khuongvanan/iot-monitoring-broadcast/hardware/esp32-controller/k3.1.csv

Reference | Qty | Value | DNP | Exclude from BOM | Exclude from Board | Exclude from Simulation | Exclude from Position Files | Footprint | Datasheet
C1,C10,C12 | 3 | 10uF/25V(20%) |  |  |  |  | ${EXCLUDE_FROM_POS_FILES} | Capacitor_SMD:C_1206_3216Metric_Pad1.33x1.80mm_HandSolder
C2,C4,C7,C8 | 4 | 0.1uF/50V(10%) |  |  |  |  | ${EXCLUDE_FROM_POS_FILES} | Capacitor_SMD:C_0805_2012Metric_Pad1.18x1.45mm_HandSolder
C3 | 1 | 10uF/5V(20%) |  |  |  |  | ${EXCLUDE_FROM_POS_FILES} | Capacitor_SMD:C_0805_2012Metric_Pad1.18x1.45mm_HandSolder
C5 | 1 | 10uF |  |  |  |  | ${EXCLUDE_FROM_POS_FILES} | Capacitor_SMD:C_0805_2012Metric_Pad1.18x1.45mm_HandSolder
C6,C11 | 2 | 0.1uF |  |  |  |  | ${EXCLUDE_FROM_POS_FILES} | Capacitor_SMD:C_0805_2012Metric_Pad1.18x1.45mm_HandSolder
C9 | 1 | 1000uF/16V |  |  |  |  | ${EXCLUDE_FROM_POS_FILES} | Capacitor_THT:CP_Radial_D8.0mm_P3.50mm
C13 | 1 | 105 |  |  |  |  | ${EXCLUDE_FROM_POS_FILES} | Capacitor_SMD:C_0805_2012Metric_Pad1.18x1.45mm_HandSolder
C14 | 1 | 1uF/16V(10%) |  |  |  |  | ${EXCLUDE_FROM_POS_FILES} | Capacitor_SMD:C_0805_2012Metric_Pad1.18x1.45mm_HandSolder
C15,C16 | 2 | 330uF/35V |  |  |  |  | ${EXCLUDE_FROM_POS_FILES} | Capacitor_THT:CP_Radial_D8.0mm_P5.00mm
D1 | 1 | 1N5822 |  |  |  |  | ${EXCLUDE_FROM_POS_FILES} | Diode_SMD:D_SMC_Handsoldering | http://www.vishay.com/docs/88526/1n5820.pdf
D2 | 1 | LED-RED |  |  |  |  | ${EXCLUDE_FROM_POS_FILES} | LED_SMD:LED_0805_2012Metric_Pad1.15x1.40mm_HandSolder
D3 | 1 | SK6805 |  |  |  |  | ${EXCLUDE_FROM_POS_FILES} | LED_SMD:LED_SK6805_PLCC4_2.4x2.7mm_P1.3mm | https://cdn-shop.adafruit.com/product-files/3484/3484_Datasheet.pdf
D4,D10 | 2 | D_Schottky |  |  |  |  | ${EXCLUDE_FROM_POS_FILES} | Diode_SMD:D_SMA_Handsoldering
D5,D6,D7,D8,D9,D11 | 6 | D_TVS |  |  |  |  | ${EXCLUDE_FROM_POS_FILES} | Diode_SMD:D_1206_3216Metric_Pad1.42x1.75mm_HandSolder
J1 | 1 | SHT31 |  |  |  |  | ${EXCLUDE_FROM_POS_FILES} | Connector_JST:JST_EH_B4B-EH-A_1x04_P2.50mm_Vertical
J2 | 1 | YG1006 |  |  |  |  | ${EXCLUDE_FROM_POS_FILES} | Connector_JST:JST_EH_B3B-EH-A_1x03_P2.50mm_Vertical
J3 | 1 | Conn_01x02 |  |  |  |  | ${EXCLUDE_FROM_POS_FILES} | TerminalBlock_Phoenix:TerminalBlock_Phoenix_MKDS-1,5-2-5.08_1x02_P5.08mm_Horizontal
J4 | 1 | USB_C ESP USB |  |  |  |  | ${EXCLUDE_FROM_POS_FILES} | Connector_USB:USB_C_Receptacle_HCTL_HC-TYPE-C-16P-01A | https://www.usb.org/sites/default/files/documents/usb_type-c.zip
J5 | 1 | USB_C USB TO UART |  |  |  |  | ${EXCLUDE_FROM_POS_FILES} | Connector_USB:USB_C_Receptacle_HCTL_HC-TYPE-C-16P-01A | https://www.usb.org/sites/default/files/documents/usb_type-c.zip
J7 | 1 | GND |  |  |  |  | ${EXCLUDE_FROM_POS_FILES} | Connector_JST:JST_EH_B3B-EH-A_1x03_P2.50mm_Vertical
J9 | 1 | Sound |  |  |  |  | ${EXCLUDE_FROM_POS_FILES} | Connector_JST:JST_EH_B5B-EH-A_1x05_P2.50mm_Vertical
J10 | 1 | 4G |  |  |  |  | ${EXCLUDE_FROM_POS_FILES} | Connector_JST:JST_EH_B5B-EH-A_1x05_P2.50mm_Vertical
L1 | 1 | 68uH/2A |  |  |  |  | ${EXCLUDE_FROM_POS_FILES} | Inductor_SMD:L_Taiyo-Yuden_NR-80xx_HandSoldering
Q1,Q2 | 2 | Q_NPN_BEC |  |  |  |  | ${EXCLUDE_FROM_POS_FILES} | Package_TO_SOT_SMD:SOT-23
R1 | 1 | 1k |  |  |  |  | ${EXCLUDE_FROM_POS_FILES} | Resistor_SMD:R_0805_2012Metric_Pad1.20x1.40mm_HandSolder
R2,R13,R14,R15 | 4 | 0(1%) |  |  |  |  | ${EXCLUDE_FROM_POS_FILES} | Resistor_SMD:R_0805_2012Metric_Pad1.20x1.40mm_HandSolder
R4,R6 | 2 | 22R |  |  |  |  | ${EXCLUDE_FROM_POS_FILES} | Resistor_SMD:R_0805_2012Metric_Pad1.20x1.40mm_HandSolder
R7,R8 | 2 | 100k |  |  |  |  | ${EXCLUDE_FROM_POS_FILES} | Resistor_SMD:R_0805_2012Metric_Pad1.20x1.40mm_HandSolder
R10,R11,R12 | 3 | 10k(1%) |  |  |  |  | ${EXCLUDE_FROM_POS_FILES} | Resistor_SMD:R_0805_2012Metric_Pad1.20x1.40mm_HandSolder
R16 | 1 | 5 .1K |  |  |  |  | ${EXCLUDE_FROM_POS_FILES} | Resistor_SMD:R_0805_2012Metric_Pad1.20x1.40mm_HandSolder
R17,R18,R19 | 3 | 5.1K |  |  |  |  | ${EXCLUDE_FROM_POS_FILES} | Resistor_SMD:R_0805_2012Metric_Pad1.20x1.40mm_HandSolder
SW1,SW2 | 2 | SW_Push |  |  |  |  | ${EXCLUDE_FROM_POS_FILES} | Button_Switch_SMD:SW_SPST_FSMSM
U1 | 1 | ESP32-S3-WROOM-1 |  |  |  |  | ${EXCLUDE_FROM_POS_FILES} | RF_Module:ESP32-S3-WROOM-1 | https://www.espressif.com/sites/default/files/documentation/esp32-s3-wroom-1_wroom-1u_datasheet_en.pdf
U2 | 1 | CH340C |  |  |  |  | ${EXCLUDE_FROM_POS_FILES} | Package_SO:SOIC-16_3.9x9.9mm_P1.27mm | https://datasheet.lcsc.com/szlcsc/Jiangsu-Qin-Heng-CH340C_C84681.pdf
U3 | 1 | AMS1117-3.3 |  |  |  |  | ${EXCLUDE_FROM_POS_FILES} | Package_TO_SOT_SMD:SOT-223-3_TabPin2 | http://www.advanced-monolithic.com/pdf/ds1117.pdf
U5 | 1 | XL1509-5.0 |  |  |  |  | ${EXCLUDE_FROM_POS_FILES} | Package_SO:SOIC-8_3.9x4.9mm_P1.27mm | https://datasheet.lcsc.com/lcsc/1809050422_XLSEMI-XL1509-5-0E1_C61063.pdf
