khuongvanan/iot-monitoring-broadcast/hardware/power-amplifier/k1.csv

Reference | Qty | Value | DNP | Exclude from BOM | Exclude from Board | Exclude from Simulation | Exclude from Position Files | Footprint | Datasheet
C1,C17 | 2 | 220uF\35V |  |  |  |  | ${EXCLUDE_FROM_POS_FILES} | Capacitor_THT:CP_Radial_D22.0mm_P10.00mm_SnapIn
C2,C5 | 2 | 100nF |  |  |  |  | ${EXCLUDE_FROM_POS_FILES} | Capacitor_SMD:C_0201_0603Metric_Pad0.64x0.40mm_HandSolder
C3,C4 | 2 | 1nF |  |  |  |  | ${EXCLUDE_FROM_POS_FILES} | Capacitor_SMD:C_0201_0603Metric_Pad0.64x0.40mm_HandSolder
C6,C16 | 2 | 1nF |  |  |  |  | ${EXCLUDE_FROM_POS_FILES} | Capacitor_SMD:C_0603_1608Metric_Pad1.08x0.95mm_HandSolder
C7 | 1 | 1uF |  |  |  |  | ${EXCLUDE_FROM_POS_FILES} | Resistor_SMD:R_0805_2012Metric_Pad1.20x1.40mm_HandSolder
C8,C14 | 2 | 1uF |  |  |  |  | ${EXCLUDE_FROM_POS_FILES} | Capacitor_SMD:C_1206_3216Metric_Pad1.33x1.80mm_HandSolder
C9,C15 | 2 | 1uF |  |  |  |  | ${EXCLUDE_FROM_POS_FILES} | Capacitor_SMD:C_0805_2012Metric_Pad1.18x1.45mm_HandSolder
C10,C11,C12,C13 | 4 | 220nF\X5R |  |  |  |  | ${EXCLUDE_FROM_POS_FILES} | Capacitor_SMD:C_0201_0603Metric_Pad0.64x0.40mm_HandSolder
J1 | 1 | POWER 15V |  |  |  |  | ${EXCLUDE_FROM_POS_FILES} | Connector:Banana_Jack_2Pin
J2 | 1 | AUDIO IN |  |  |  |  | ${EXCLUDE_FROM_POS_FILES} | Connector:Banana_Jack_2Pin
J3 | 1 | AUDIO OUT |  |  |  |  | ${EXCLUDE_FROM_POS_FILES} | Connector:Banana_Jack_2Pin
L1,L2 | 2 | 10uH |  |  |  |  | ${EXCLUDE_FROM_POS_FILES} | Inductor_SMD:L_Panasonic_PCC-M1050M
R1,R3,R4 | 3 | 100k |  |  |  |  | ${EXCLUDE_FROM_POS_FILES} | Resistor_SMD:R_0603_1608Metric_Pad0.98x0.95mm_HandSolder
R2 | 1 | 20k |  |  |  |  | ${EXCLUDE_FROM_POS_FILES} | Resistor_SMD:R_0603_1608Metric_Pad0.98x0.95mm_HandSolder
R5,R6 | 2 | 3.3R |  |  |  |  | ${EXCLUDE_FROM_POS_FILES} | Resistor_SMD:R_0805_2012Metric_Pad1.20x1.40mm_HandSolder
U3 | 1 | TPA3118D2DAPR |  |  |  |  | ${EXCLUDE_FROM_POS_FILES} | TPA3118D2DAPR:SOP65P810X120-33N
