khuongvanan/iot-monitoring-broadcast/hardware/audio-dac/k2.2.kicad_pcb

## KiCad design hardware/audio-dac/k2.2.kicad_pcb (2026-10-30)

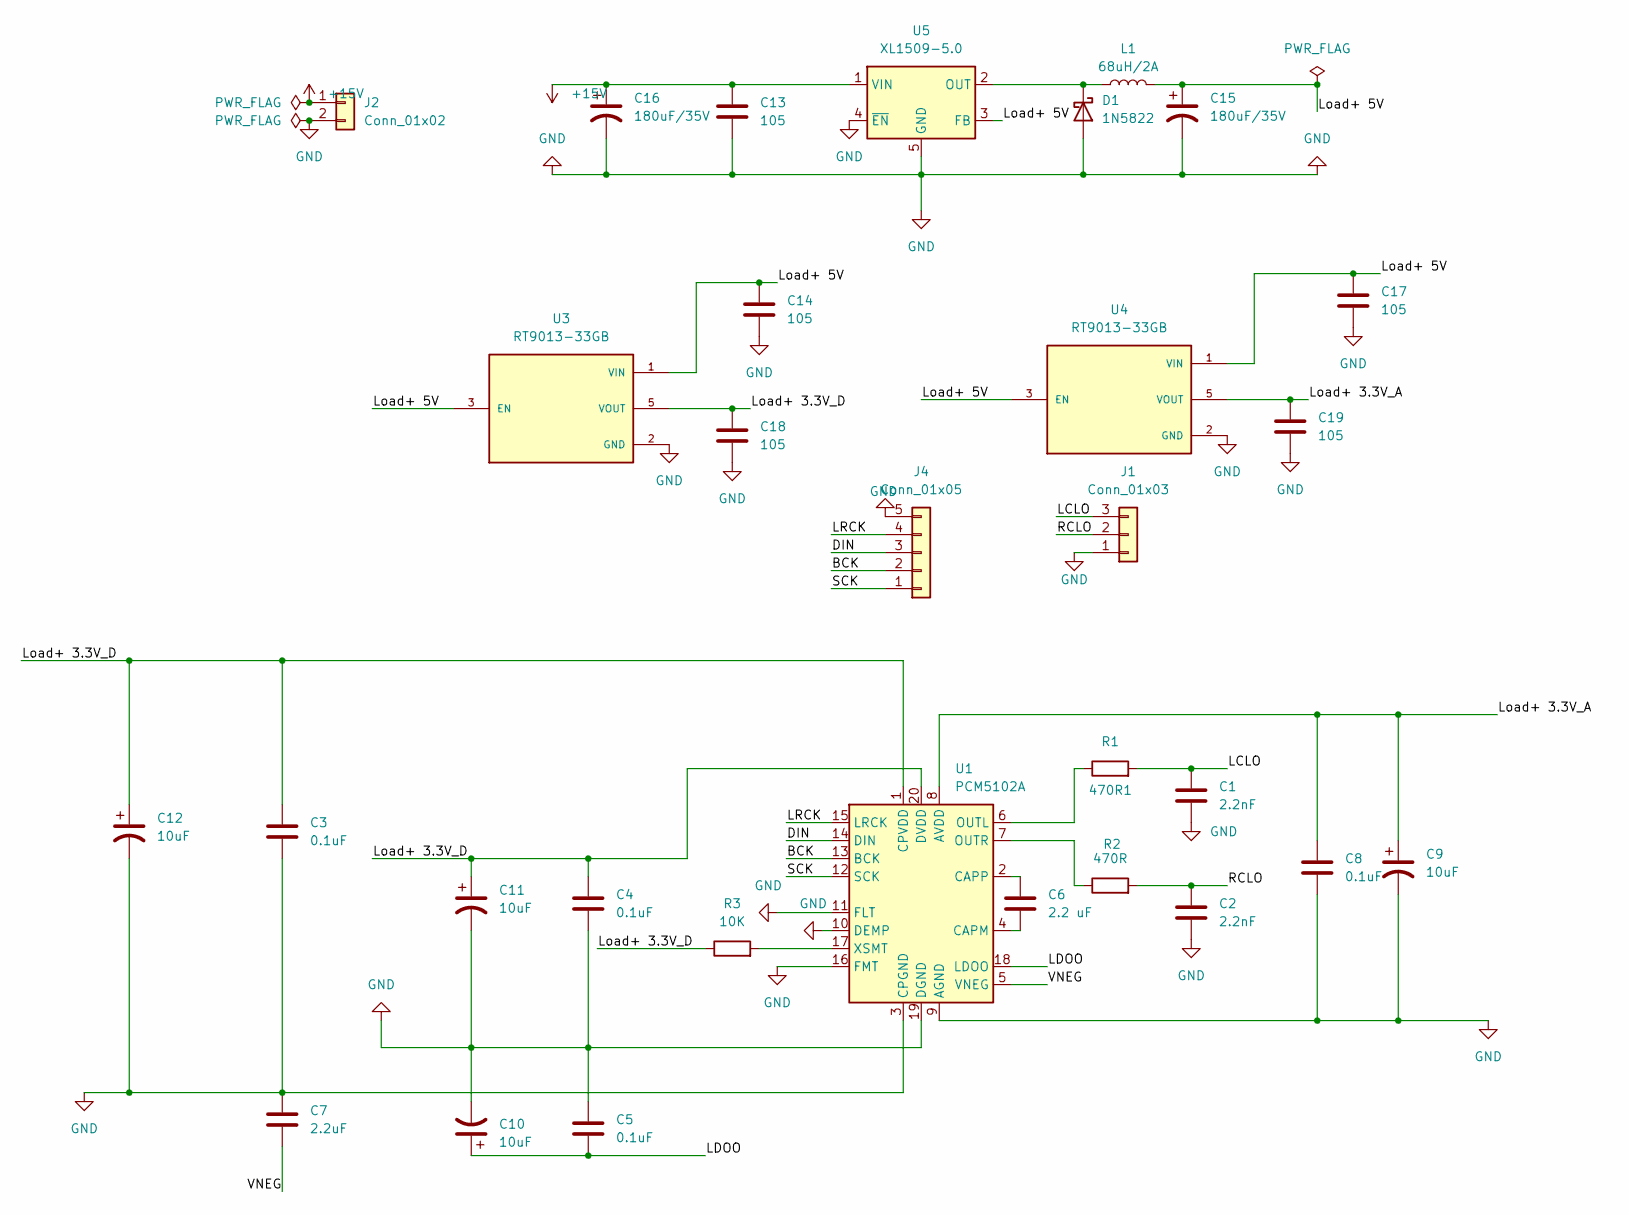
[picture p1: schematic k2.2.kicad_sch]

Parts:
470R1: R1; R_0805_2012Metric_Pad1.20x1.40mm_HandSolder
C1, C2: 2.2nF; C_0805_2012Metric_Pad1.18x1.45mm_HandSolder
C3, C4, C5, C8: 0.1uF; C_0805_2012Metric_Pad1.18x1.45mm_HandSolder
C6: 2.2 uF; C_0805_2012Metric_Pad1.18x1.45mm_HandSolder
C7: 2.2uF; C_0805_2012Metric_Pad1.18x1.45mm_HandSolder
C9, C10, C11, C12: 10uF; C_0805_2012Metric_Pad1.18x1.45mm_HandSolder
C13, C14, C17, C18, C19: 105; C_0805_2012Metric_Pad1.18x1.45mm_HandSolder
C15, C16: 180uF/35V; CP_Radial_D6.3mm_P2.50mm
D1: 1N5822; D_SMC_Handsoldering
J1: Conn_01x03; JST_EH_B3B-EH-A_1x03_P2.50mm_Vertical
J2: Conn_01x02; TerminalBlock_Phoenix_MKDS-1,5-2_1x02_P5.00mm_Horizontal
J4: Conn_01x05; JST_EH_B5B-EH-A_1x05_P2.50mm_Vertical
L1: 68uH/2A; L_Taiyo-Yuden_NR-80xx_HandSoldering
R2: 470R; R_0805_2012Metric_Pad1.20x1.40mm_HandSolder
R3: 10K; R_0805_2012Metric_Pad1.20x1.40mm_HandSolder
U1: PCM5102A; TSSOP-20_4.4x6.5mm_P0.65mm
U3, U4: RT9013-33GB; SOT94P279X129-5N; PARTREV Aprill 2011
U5: XL1509-5.0; SOIC-8_3.9x4.9mm_P1.27mm

Connections:
+15V: C13.1, C16.1, J2.1, U5.1 (VIN)
/BCK: J4.2, U1.13 (BCK); also elsewhere on the board
/DIN: J4.3, U1.14 (DIN); also elsewhere on the board
/LCLO: 470R1.2, C1.2, J1.3; also elsewhere on the board
/LDOO: C5.2, C10.1, U1.18 (LDOO)
/LRCK: J4.4, U1.15 (LRCK); also elsewhere on the board
/Load+ 3.3V_A: C8.1, C9.1, C19.1, U1.8 (AVDD), U4.5 (VOUT)
/Load+ 3.3V_D: C3.1, C4.1, C11.1, C12.1, C18.1, R3.1, U1.1 (CPVDD), U1.20 (DVDD), U3.5 (VOUT)
/Load+ 5V: C14.1, C15.1, C17.1, L1.2, U3.1 (VIN), U3.3 (EN), U4.1 (VIN), U4.3 (EN), U5.3 (FB)
/RCLO: C2.2, J1.2, R2.2
/SCK: J4.1, U1.12 (SCK); also elsewhere on the board
/VNEG: C7.1, U1.5 (VNEG)
GND: C1.1, C2.1, C3.2, C4.2, C5.1, C7.2, C8.2, C9.2, C10.2, C11.2, C12.2, C13.2, C14.2, C15.2, C16.2, C17.2, C18.2, C19.2, D1.2 (A), J1.1, J2.2, J4.5, U1.3 (CPGND), U1.9 (AGND), U1.10 (DEMP), U1.11 (FLT), U1.16 (FMT), U1.19 (DGND), U3.2 (GND), U4.2 (GND), U5.4 (~EN), U5.5 (GND), U5.6 (GND), U5.7 (GND), U5.8 (GND); also elsewhere on the board
unnamed: D1.1 (K), L1.1, U5.2 (OUT)
unnamed: C6.2, U1.4 (CAPM)
unnamed: C6.1, U1.2 (CAPP)
unnamed 16: 470R1.1, U1.6 (OUTL); also elsewhere on the board
unnamed: R2.1, U1.7 (OUTR)
unnamed: R3.2, U1.17 (XSMT)

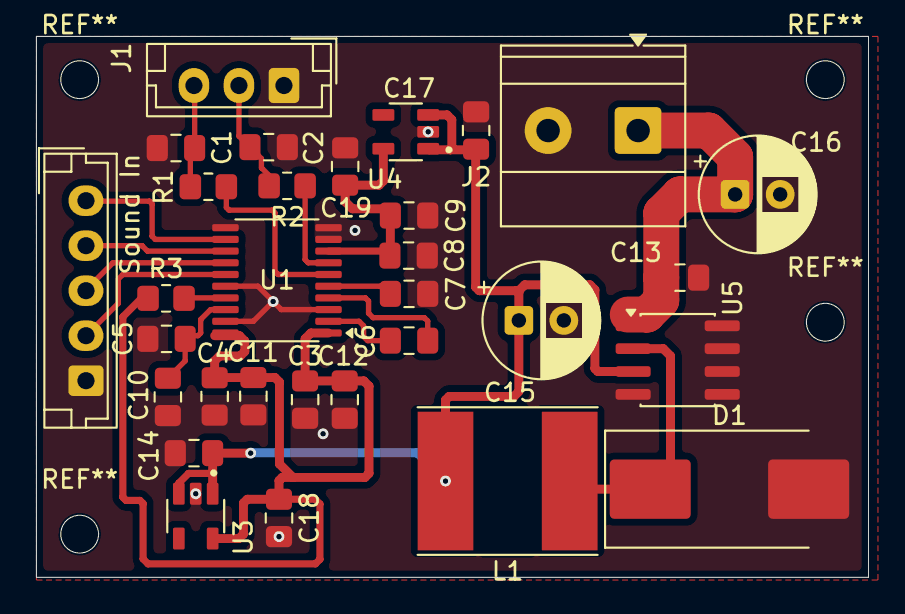
[picture p2: board k2.2.kicad_pcb from above]

Board: 2 copper layers, 46.2 x 30.0 mm, 31 parts (0 on the bottom side), 19 nets.

Other parts of the board:
R1: R1; R_0805_2012Metric_Pad1.20x1.40mm_HandSolder
Sound In: Conn_01x05; JST_EH_B5B-EH-A_1x05_P2.50mm_Vertical

Their connections:
/BCK: Sound In.2; also elsewhere on the board
/DIN: Sound In.3; also elsewhere on the board
/LCLO: R1.2; also elsewhere on the board
/LRCK: Sound In.4; also elsewhere on the board
/SCK: Sound In.1; also elsewhere on the board
GND: Sound In.5; also elsewhere on the board
unnamed 16: R1.1; also elsewhere on the board
