khuongvanan/iot-monitoring-broadcast/hardware/power-amplifier/k1.kicad_pcb

## KiCad design hardware/power-amplifier/k1.kicad_pcb (2026-10-30)

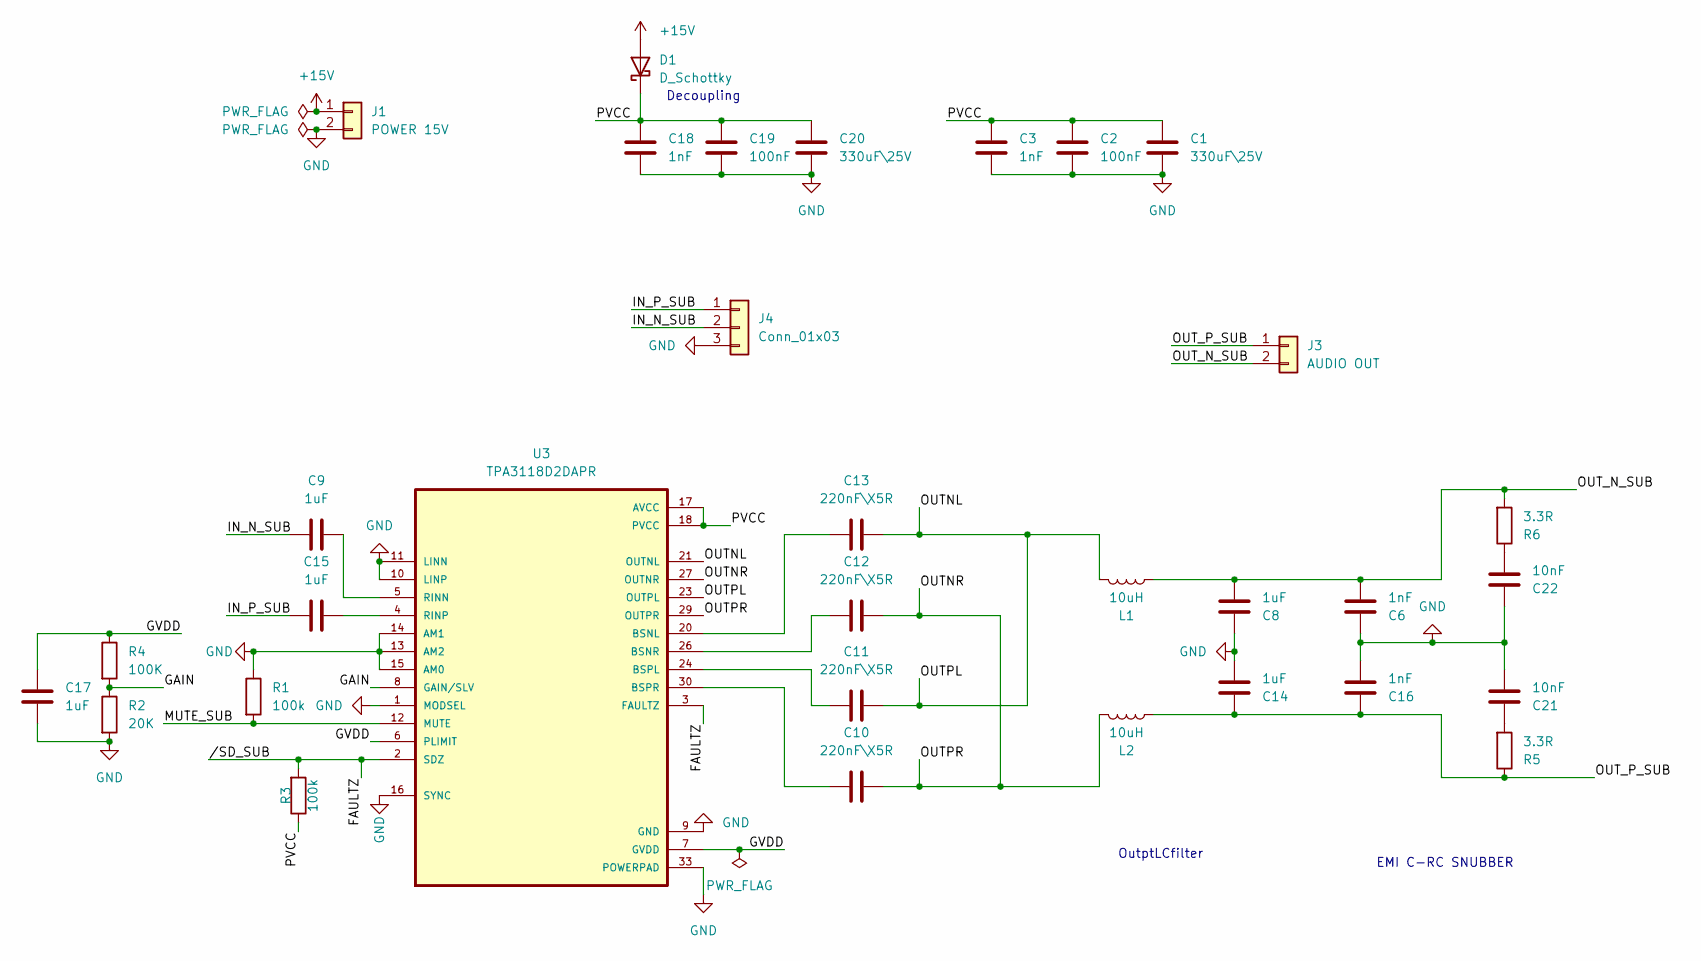
[picture p3: schematic k1.kicad_sch]

Parts:
C1, C20: 330uF\25V; CP_Radial_D8.0mm_P3.50mm
C2, C19: 100nF; C_0805_2012Metric_Pad1.18x1.45mm_HandSolder
C3, C6, C16, C18: 1nF; C_0805_2012Metric_Pad1.18x1.45mm_HandSolder
C8, C14: 1uF; C_1206_3216Metric_Pad1.33x1.80mm_HandSolder
C9, C15, C17: 1uF; C_0805_2012Metric_Pad1.18x1.45mm_HandSolder
C10, C11, C12, C13: 220nF\X5R; C_0805_2012Metric_Pad1.18x1.45mm_HandSolder
C21, C22: 10nF; C_0805_2012Metric_Pad1.18x1.45mm_HandSolder
D1: D_Schottky
J1: POWER 15V; TerminalBlock_Phoenix_MKDS-1,5-2_1x02_P5.00mm_Horizontal
J3: AUDIO OUT; TerminalBlock_Phoenix_MKDS-1,5-2_1x02_P5.00mm_Horizontal
J4: Conn_01x03; JST_EH_B3B-EH-A_1x03_P2.50mm_Vertical
L1, L2: 10uH; L_Taiyo-Yuden_NR-10050_9.8x10.0mm_HandSoldering
R1, R3: 100k; R_0805_2012Metric_Pad1.20x1.40mm_HandSolder
R2: 20K; R_0805_2012Metric_Pad1.20x1.40mm_HandSolder
R4: 100K; R_0805_2012Metric_Pad1.20x1.40mm_HandSolder
R5, R6: 3.3R; R_0805_2012Metric_Pad1.20x1.40mm_HandSolder
U3: TPA3118D2DAPR; SOP65P810X120-33N; DigiKey_Part_Number 296-38572-1-ND

Connections:
+15V: D1.2 (A), J1.1
/FAULTZ: R3.2, U3.2 (SDZ), U3.3 (FAULTZ)
/GAIN: R2.1, R4.2, U3.8 (GAIN/SLV)
/GVDD: C17.2, R4.1, U3.6 (PLIMIT), U3.7 (GVDD)
/IN_N_SUB: C9.1, J4.2
/IN_P_SUB: C15.1, J4.1
/MUTE_SUB: R1.2, U3.12 (MUTE)
/OUTNL: C11.2, C13.2, L1.1, U3.21 (OUTNL), U3.23 (OUTPL)
/OUTNR: C10.2, C12.2, L2.1, U3.27 (OUTNR), U3.29 (OUTPR)
/OUT_N_SUB: C6.2, C8.2, J3.2, L1.2, R6.2
/OUT_P_SUB: C14.1, C16.1, J3.1, L2.2, R5.1
GND: C1.2, C2.2, C3.2, C6.1, C8.1, C14.2, C16.2, C17.1, C18.2, C19.2, C20.2, C21.2, C22.1, J1.2, J4.3, R1.1, R2.2, U3.1 (MODSEL), U3.9 (GND), U3.10 (LINP), U3.11 (LINN), U3.13 (AM2), U3.14 (AM1), U3.15 (AM0), U3.16 (SYNC), U3.22 (GND), U3.25 (GND), U3.28 (GND), U3.33 (POWERPAD)
unnamed: C21.1, R5.2
unnamed: C22.2, R6.1
unnamed: C13.1, U3.20 (BSNL)
unnamed: C12.1, U3.26 (BSNR)
unnamed: C11.1, U3.24 (BSPL)
unnamed: C10.1, U3.30 (BSPR)
unnamed: C9.2, U3.5 (RINN)
unnamed: C15.2, U3.4 (RINP)
PVCC: C1.1, C2.1, C3.1, C18.1, C19.1, C20.1, D1.1 (K), R3.1, U3.17 (AVCC), U3.18 (PVCC), U3.19 (PVCC), U3.31 (PVCC), U3.32 (PVCC)

Notes on the sheet:
OutptLCfilter
Decoupling
EMI C-RC SNUBBER

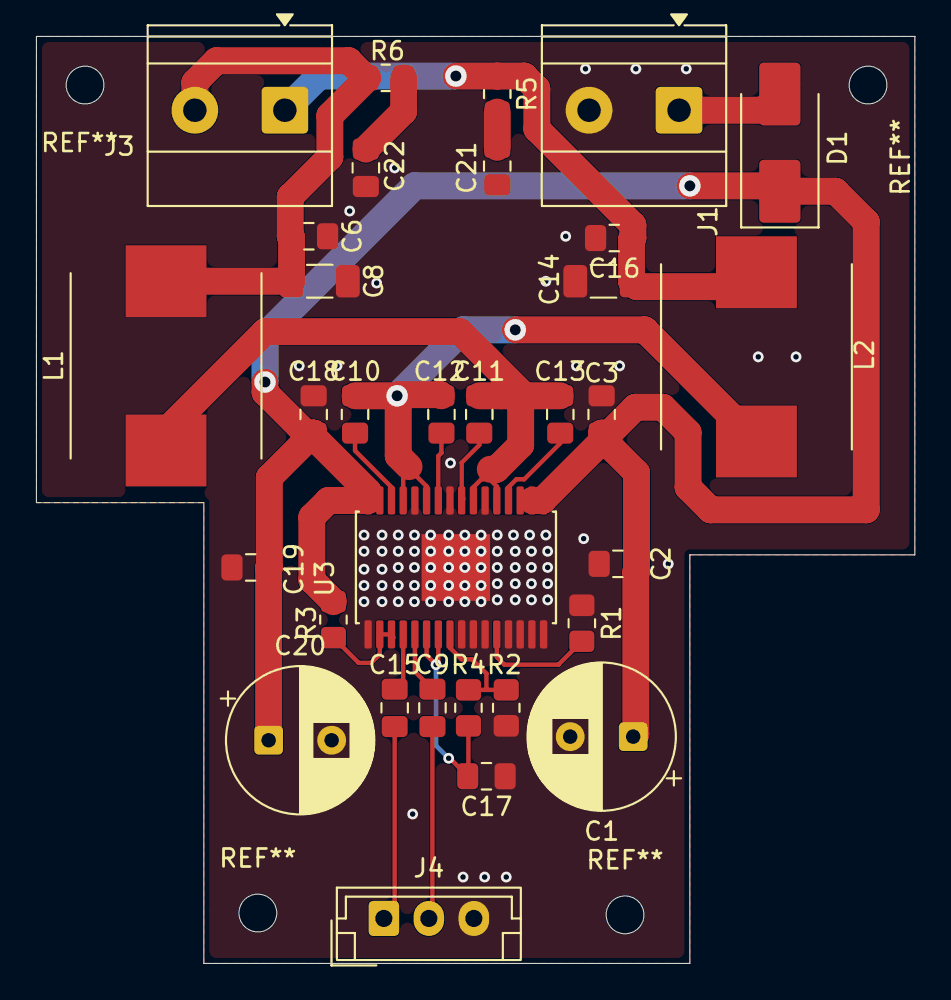
[picture p4: board k1.kicad_pcb from above]

Board: 2 copper layers, 48.8 x 51.5 mm, 32 parts (0 on the bottom side), 21 nets.
