khuongvanan/iot-monitoring-broadcast/hardware/esp32-controller/k3.1.kicad_pcb

## KiCad design hardware/esp32-controller/k3.1.kicad_pcb (2026-10-30)

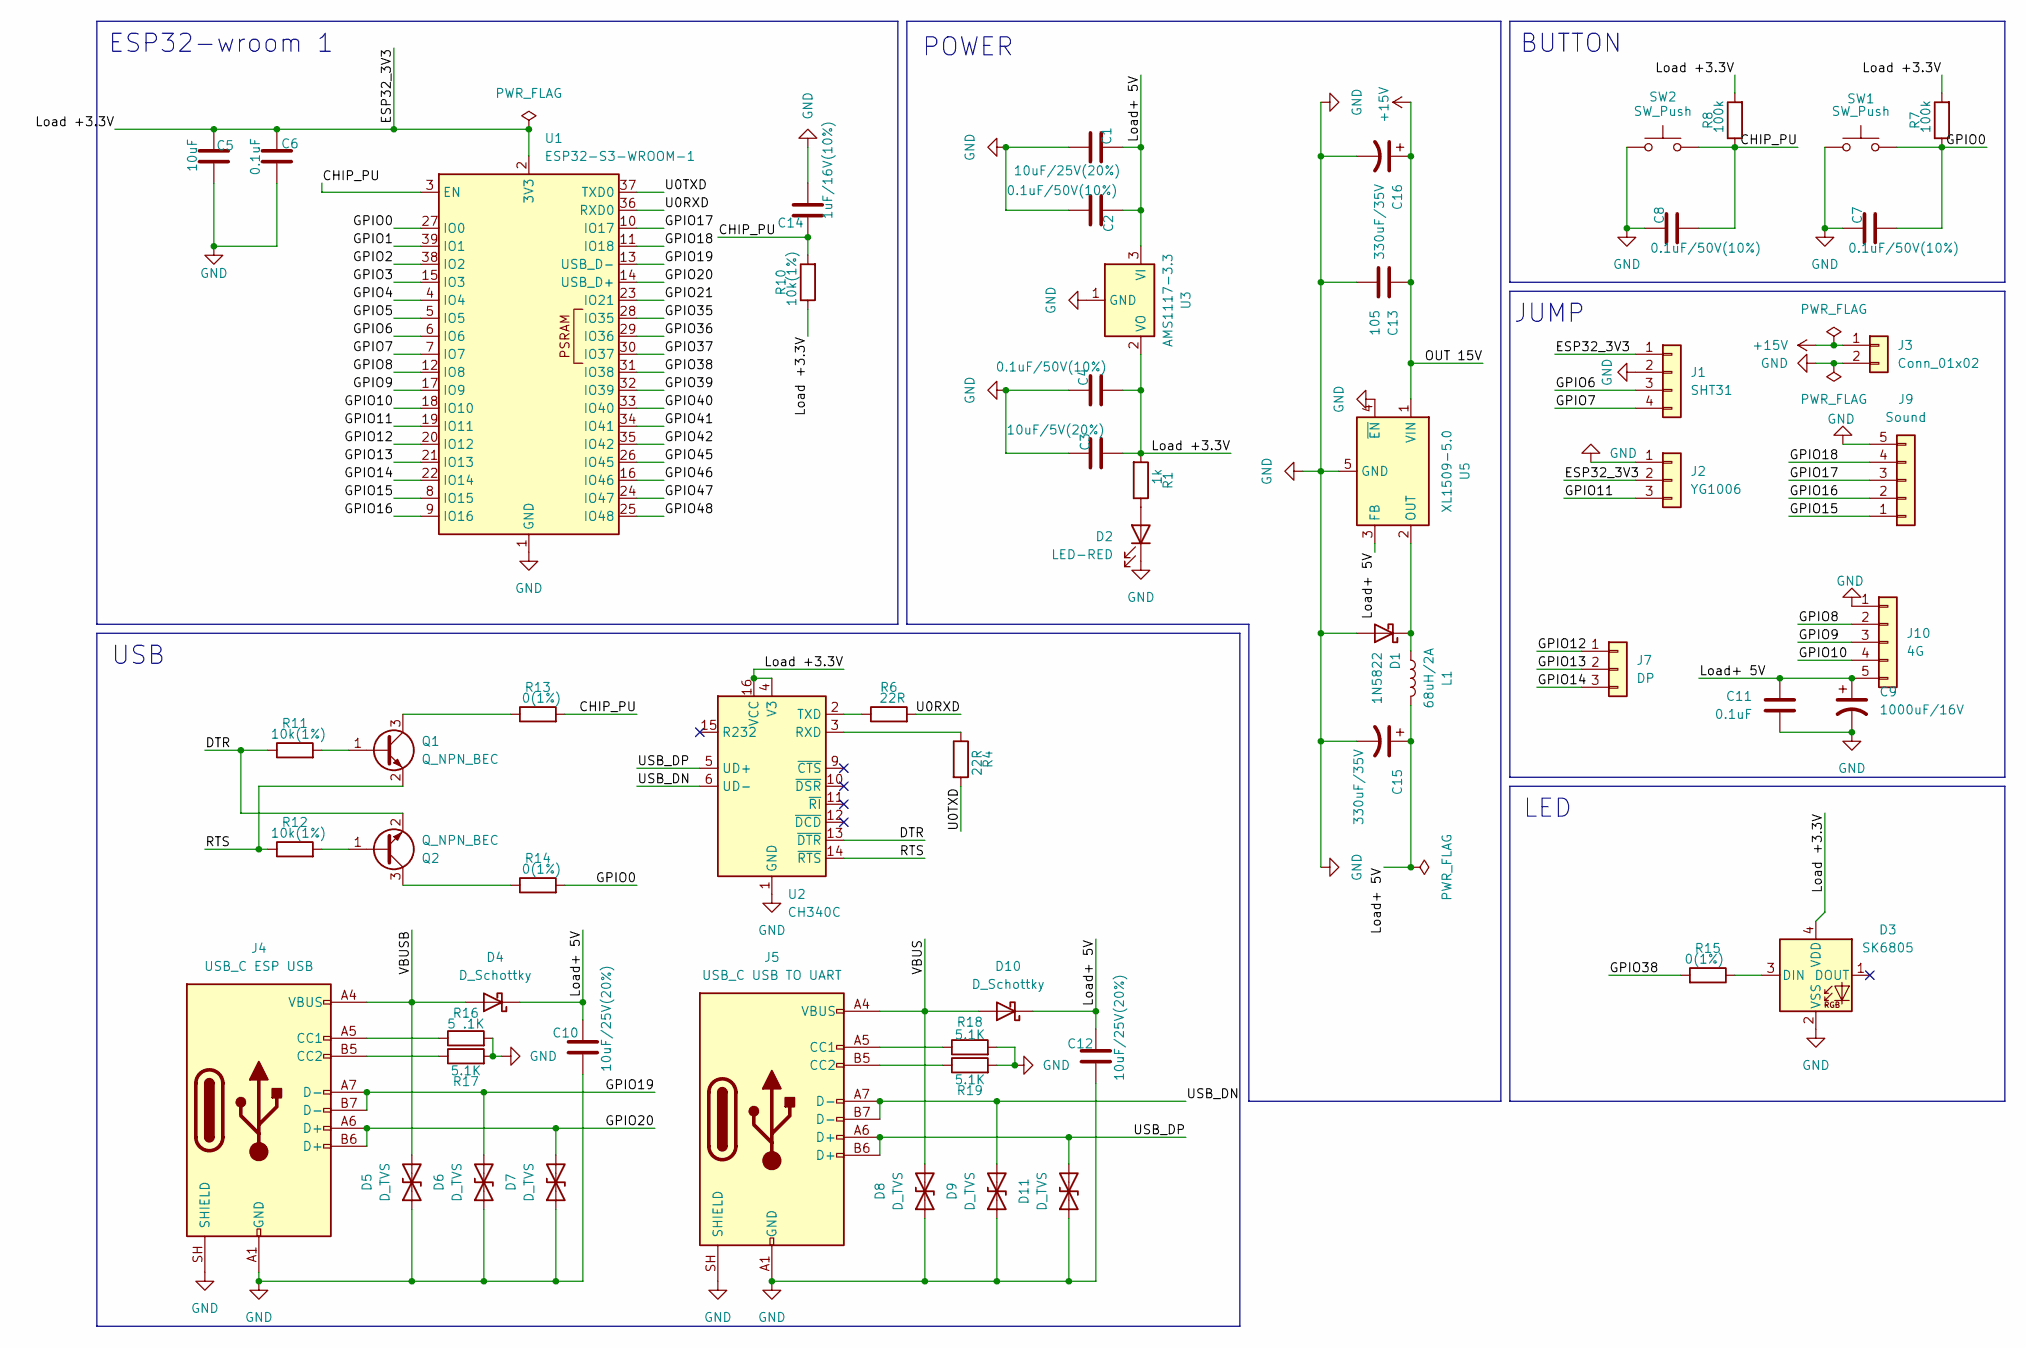
[picture p5: schematic k3.1.kicad_sch]

Parts:
C1, C10, C12: 10uF/25V(20%); C_1206_3216Metric_Pad1.33x1.80mm_HandSolder
C2, C4, C7, C8: 0.1uF/50V(10%); C_0805_2012Metric_Pad1.18x1.45mm_HandSolder
C3: 10uF/5V(20%); C_0805_2012Metric_Pad1.18x1.45mm_HandSolder
C5: 10uF; C_0805_2012Metric_Pad1.18x1.45mm_HandSolder
C6, C11: 0.1uF; C_0805_2012Metric_Pad1.18x1.45mm_HandSolder
C9: 1000uF/16V; CP_Radial_D8.0mm_P3.50mm
C13: 105; C_0805_2012Metric_Pad1.18x1.45mm_HandSolder
C14: 1uF/16V(10%); C_0805_2012Metric_Pad1.18x1.45mm_HandSolder
C15, C16: 330uF/35V; CP_Radial_D8.0mm_P5.00mm
D1: 1N5822; D_SMC_Handsoldering
D2: LED-RED; LED_0805_2012Metric_Pad1.15x1.40mm_HandSolder
D3: SK6805; LED_SK6805_PLCC4_2.4x2.7mm_P1.3mm
D4, D10: D_Schottky; D_SMA_Handsoldering
D5, D6, D7, D8, D9, D11: D_TVS; D_1206_3216Metric_Pad1.42x1.75mm_HandSolder
J1: SHT31; JST_EH_B4B-EH-A_1x04_P2.50mm_Vertical
J2: YG1006; JST_EH_B3B-EH-A_1x03_P2.50mm_Vertical
J3: Conn_01x02; TerminalBlock_Phoenix_MKDS-1,5-2-5.08_1x02_P5.08mm_Horizont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
J4: USB_C ESP USB; USB_C_Receptacle_HCTL_HC-TYPE-C-16P-01A
J5: USB_C USB TO UART; USB_C_Receptacle_HCTL_HC-TYPE-C-16P-01A
J7: DP; JST_EH_B3B-EH-A_1x03_P2.50mm_Vertical
J9: Sound; JST_EH_B5B-EH-A_1x05_P2.50mm_Vertical
J10: 4G; JST_EH_B5B-EH-A_1x05_P2.50mm_Vertical
L1: 68uH/2A; L_Taiyo-Yuden_NR-80xx_HandSoldering
Q1, Q2: Q_NPN_BEC; SOT-23
R1: 1k; R_0805_2012Metric_Pad1.20x1.40mm_HandSolder
R4, R6: 22R; R_0805_2012Metric_Pad1.20x1.40mm_HandSolder
R7, R8: 100k; R_0805_2012Metric_Pad1.20x1.40mm_HandSolder
R10, R11, R12: 10k(1%); R_0805_2012Metric_Pad1.20x1.40mm_HandSolder
R13, R14, R15: 0(1%); R_0805_2012Metric_Pad1.20x1.40mm_HandSolder
R16: 5 .1K; R_0805_2012Metric_Pad1.20x1.40mm_HandSolder
R17, R18, R19: 5.1K; R_0805_2012Metric_Pad1.20x1.40mm_HandSolder
SW1, SW2: SW_Push; SW_SPST_FSMSM
U1: ESP32-S3-WROOM-1
U2: CH340C; SOIC-16_3.9x9.9mm_P1.27mm
U3: AMS1117-3.3; SOT-223-3_TabPin2
U5: XL1509-5.0; SOIC-8_3.9x4.9mm_P1.27mm

Connections:
+15V: C13.1, C16.1, J3.1, U5.1 (VIN)
/CHIP_PU: C8.2, C14.1, R8.1, R10.2, R13.2, SW2.2, U1.3 (EN)
/DTR: Q2.2 (E), R11.1, U2.13 (~DTR)
/ESP32_3V3: C3.2, C4.2, C5.1, C6.1, D3.4 (VDD), J1.1, J2.2, R1.2, R7.2, R8.2, R10.1, U1.2 (3V3), U2.4 (V3), U2.16 (VCC), U3.2 (VO)
/GPIO0: C7.2, R7.1, R14.2, SW1.2, U1.27 (IO0)
/GPIO1: U1.39 (IO1)
/GPIO2: U1.38 (IO2)
/GPIO3: U1.15 (IO3)
/GPIO4: U1.4 (IO4)
/GPIO5: U1.5 (IO5)
/GPIO6: J1.3, U1.6 (IO6)
/GPIO7: J1.4, U1.7 (IO7)
/GPIO8: J10.2, U1.12 (IO8); also elsewhere on the board
/GPIO9: J10.3, U1.17 (IO9); also elsewhere on the board
/GPIO10: J10.4, U1.18 (IO10); also elsewhere on the board
/GPIO11: J2.3, U1.19 (IO11)
/GPIO12: J7.1, U1.20 (IO12)
/GPIO13: J7.2, U1.21 (IO13)
/GPIO14: J7.3, U1.22 (IO14)
/GPIO15: J9.1, U1.8 (IO15)
/GPIO16: J9.2, U1.9 (IO16)
/GPIO17: J9.3, U1.10 (IO17)
/GPIO18: J9.4, U1.11 (IO18)
/GPIO19: D6.2 (A2), J4.A7 (D-), J4.B7 (D-), U1.13 (USB_D-)
/GPIO20: D7.2 (A2), J4.A6 (D+), J4.B6 (D+), U1.14 (USB_D+)
/GPIO21: U1.23 (IO21)
/GPIO35: U1.28 (IO35)
/GPIO36: U1.29 (IO36)
/GPIO37: U1.30 (IO37)
/GPIO38: R15.2, U1.31 (IO38)
/GPIO39: U1.32 (IO39)
/GPIO40: U1.33 (IO40)
/GPIO41: U1.34 (IO41)
/GPIO42: U1.35 (IO42)
/GPIO45: U1.26 (IO45)
/GPIO46: U1.16 (IO46)
/GPIO47: U1.24 (IO47)
/GPIO48: U1.25 (IO48)
/Load+ 5V: C1.1, C2.1, C9.1, C10.2, C11.1, C12.2, C15.1, D4.1 (K), D10.1 (K), J10.5, L1.2, U3.3 (VI), U5.3 (FB); also elsewhere on the board
/RTS: Q1.2 (E), R12.1, U2.14 (~RTS)
/U0RXD: R6.2, U1.36 (RXD0)
/U0TXD: R4.2, U1.37 (TXD0)
/USB_DN: D9.2 (A2), J5.A7 (D-), J5.B7 (D-), U2.6 (UD-)
/USB_DP: D11.2 (A2), J5.A6 (D+), J5.B6 (D+), U2.5 (UD+)
/VBUS: D8.2 (A2), D10.2 (A), J5.A4 (VBUS), J5.A9 (VBUS), J5.B4 (VBUS), J5.B9 (VBUS)
/VBUSB: D4.2 (A), D5.2 (A2), J4.A4 (VBUS), J4.A9 (VBUS), J4.B4 (VBUS), J4.B9 (VBUS)
GND: C1.2, C2.2, C3.1, C4.1, C5.2, C6.2, C7.1, C8.1, C9.2, C10.1, C11.2, C12.1, C13.2, C14.2, C15.2, C16.2, D1.2 (A), D2.1 (K), D3.2 (VSS), D5.1 (A1), D6.1 (A1), D7.1 (A1), D8.1 (A1), D9.1 (A1), D11.1 (A1), J1.2, J2.1, J3.2, J4.A1 (GND), J4.A12 (GND), J4.B1 (GND), J4.B12 (GND), J4.SH (SHIELD), J5.A1 (GND), J5.A12 (GND), J5.B1 (GND), J5.B12 (GND), J5.SH (SHIELD), J9.5, J10.1, R16.2, R17.2, R18.2, R19.2, SW1.1, SW2.1, U1.1 (GND), U1.40 (GND), U1.41 (GND), U2.1 (GND), U3.1 (GND), U5.4 (~EN), U5.5 (GND), U5.6 (GND), U5.7 (GND), U5.8 (GND); also elsewhere on the board
unnamed: D1.1 (K), L1.1, U5.2 (OUT)
unnamed: D2.2 (A), R1.1
unnamed: D3.3 (DIN), R15.1
unnamed: J4.A5 (CC1), R16.1
unnamed: J4.B5 (CC2), R17.1
unnamed: J5.A5 (CC1), R18.1
unnamed: J5.B5 (CC2), R19.1
unnamed: Q1.1 (B), R11.2
unnamed: Q1.3 (C), R13.1
unnamed: Q2.1 (B), R12.2
unnamed: Q2.3 (C), R14.1
unnamed: R4.1, U2.3 (RXD)
unnamed: R6.1, U2.2 (TXD)

Notes on the sheet:
POWER
BUTTON
JUMP
ESP32-wroom 1
LED
USB

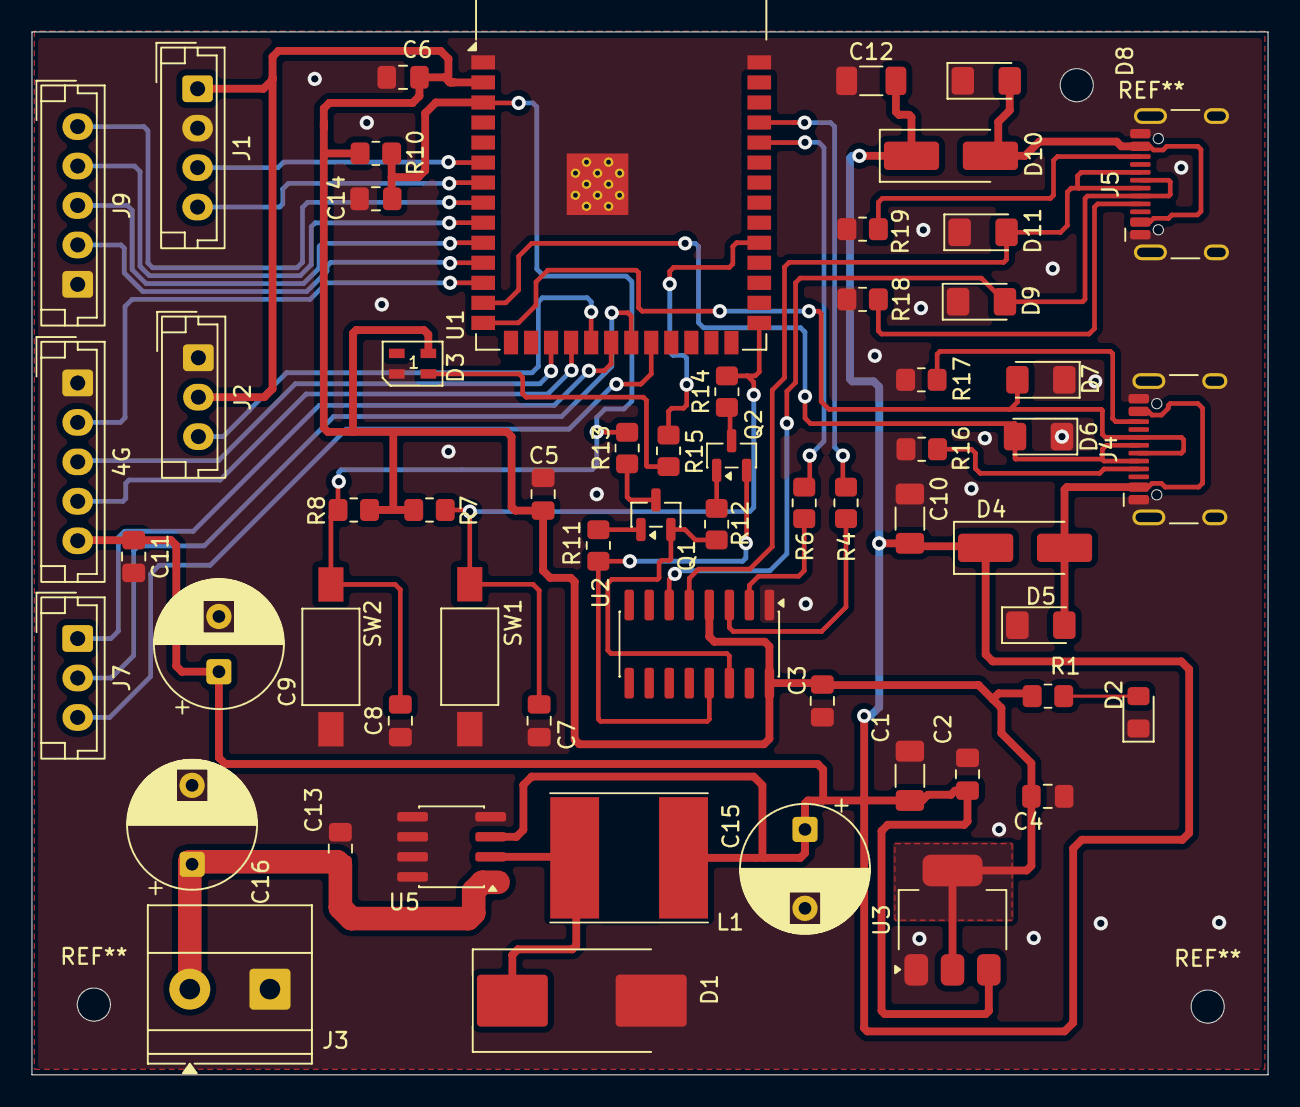
[picture p6: board k3.1.kicad_pcb from above]

Board: 2 copper layers, 78.3 x 66.1 mm, 59 parts (0 on the bottom side), 43 nets.

Other parts of the board:
4G: 4G; JST_EH_B5B-EH-A_1x05_P2.50mm_Vertical

Their connections:
/GPIO8: 4G.2; also elsewhere on the board
/GPIO9: 4G.3; also elsewhere on the board
/GPIO10: 4G.4; also elsewhere on the board
/Load+ 5V: 4G.5; also elsewhere on the board
GND: 4G.1; also elsewhere on the board
