khuongvanan/iot-monitoring-broadcast/firmware/School_Node/fire_alert.h

#pragma once
#include <Arduino.h>


static const uint8_t FIRE_MP3[] PROGMEM = {
0xff,0xf3,0x84,0xc4,0x00,0x00,0x00,0x00,0x00,0x00,0x00,0x00,0x00,0x00,0x00,0x00,
0x00,0x00,0x00,0x00,0x00,0x00,0x00,0x00,0x00,0x00,0x00,0x00,0x00,0x00,0x00,0x00,
0x00,0x00,0x00,0x00,0x00,0x00,0x00,0x00,0x00,0x00,0x00,0x00,0x00,0x00,0x00,0x00,
0x00,0x00,0x00,0x00,0x00,0x00,0x00,0x00,0x00,0x00,0x00,0x00,0x00,0x00,0x00,0x00,
0x00,0x00,0x00,0x00,0x00,0x00,0x00,0x00,0x00,0x00,0x00,0x00,0x00,0x00,0x00,0x00,
0x00,0x00,0x00,0x00,0x00,0x00,0x00,0x00,0x00,0x00,0x00,0x00,0x00,0x00,0x00,0x00,
0x00,0x00,0x00,0x00,0x00,0x00,0x00,0x00,0x00,0x00,0x00,0x00,0x00,0x00,0x00,0x00,
0x00,0x00,0x00,0x00,0x00,0x00,0x00,0x00,0x00,0x00,0x00,0x00,0x00,0x00,0x00,0x00,
0x00,0x00,0x00,0x00,0x00,0x00,0x00,0x00,0x00,0x00,0x00,0x00,0x00,0x00,0x00,0x00,
0x00,0x00,0x00,0x00,0x00,0x00,0x00,0x00,0x00,0x00,0x00,0x00,0x00,0x00,0x00,0x00,
0x00,0x00,0x00,0x00,0x00,0x00,0x00,0x00,0x00,0x00,0x00,0x00,0x00,0x00,0x00,0x00,
0x00,0x00,0x00,0x00,0x00,0x00,0x00,0x00,0x00,0x00,0x00,0x00,0x00,0x00,0x00,0x00,
0xff,0xf3,0x84,0xc4,0x00,0x25,0xd2,0xad,0xfc,0x00,0xc2,0x46,0xb9,0x37,0x10,0x80,
0x67,0x14,0xae,0x28,0xa5,0x48,0xc4,0xb3,0x95,0x21,0x88,0x72,0x59,0x56,0xde,0x1b,
0xea,0xe8,0xd1,0xea,0x8c,0x65,0x65,0x42,0x10,0x86,0x28,0x81,0x03,0x73,0x5d,0x18,
0xac,0x9f,0x6d,0x1a,0x04,0x04,0x01,0x40,0xc0,0xa1,0x88,0x42,0x73,0xf0,0x40,0xc6,
0x78,0x11,0x8a,0xc5,0x68,0xd1,0x81,0xbb,0xba,0x00,0x00,0x00,0x27,0x10,0xba,0xe7,
0xd7,0x73,0x78,0x85,0x11,0x3c,0xf7,0x88,0x51,0x10,0x38,0x18,0xb7,0x77,0x77,0x74,
0x08,0x00,0x21,0x2c,0x44,0x77,0x77,0xae,0xfe,0x5f,0xd7,0x7f,0x4d,0x13,0x88,0x82,
0x05,0x81,0x8b,0x77,0x0e,0x06,0x06,0x06,0x00,0x20,0x20,0x00,0x02,0x20,0x84,0x0f,
0x0f,0x0f,0x0f,0x1d,0xff,0x80,0x8f,0x80,0x60,0x07,0x43,0xff,0xff,0xff,0xff,0xfd,
0xe6,0x79,0x98,0x19,0xfb,0xff,0x8f,0xe1,0xe1,0xe1,0xe1,0xe1,0x80,0x00,0x00,0x00,
0x01,0xe1,0xe1,0xe3,0xd5,0x35,0x29,0xa3,0xd4,0x5e,0x05,0x00,0x91,0x13,0x05,0x40,
0x53,0x59,0x88,0x43,0x2d,0x6e,0xe3,0x97,0x03,0xc6,0x20,0x59,0xa9,0xbb,0xb6,0xe4,
0xff,0xf3,0x84,0xc4,0x1b,0x25,0x9b,0xb2,0x10,0x00,0xd9,0x86,0xdc,0x3f,0x94,0xc2,
0x60,0xf3,0x72,0x23,0x9d,0x89,0xb1,0x43,0xd0,0x70,0xb0,0xc5,0x9e,0x70,0x11,0x16,
0xd2,0x04,0x28,0x8c,0x84,0xc8,0x92,0x02,0xa8,0x28,0xe6,0x3c,0x90,0x12,0x28,0xb4,
0x9e,0x98,0x12,0x34,0x73,0x4d,0xce,0x26,0xc5,0xe3,0x47,0xb4,0x31,0x33,0x3e,0xfc,
0x32,0x15,0x76,0x76,0x14,0x78,0x67,0x31,0xb6,0xfc,0x11,0x47,0x3a,0xb5,0x43,0x12,
0x1c,0x46,0xcd,0x8c,0xd5,0x72,0x18,0x90,0x94,0xe3,0x3c,0x68,0xc6,0x45,0x7c,0x8b,
0x2e,0x9f,0x91,0xd5,0x39,0x21,0x43,0x86,0xa5,0x5d,0xf3,0x22,0x86,0xd3,0x38,0xaf,
0x48,0x17,0x27,0x3f,0x3f,0xf7,0x9e,0xa6,0x79,0x65,0xd3,0x3c,0xbf,0x81,0x13,0x06,
0x80,0xa3,0x06,0x9d,0xa4,0xff,0x15,0xc2,0xaa,0x34,0x85,0x90,0xd4,0x48,0xb0,0x10,
0x88,0xb7,0x46,0x14,0x0c,0x20,0x39,0xad,0x45,0x59,0xcd,0x78,0xa4,0xdb,0xb6,0xfb,
0xca,0x22,0x8e,0x24,0xd4,0x32,0xfe,0x41,0xd3,0xed,0xf4,0x1d,0x4a,0xfe,0x46,0x05,
0x44,0x94,0x1f,0xe8,0x58,0x5c,0xb9,0x38,0x58,0x54,0x71,0xd8,0x2c,0xc3,0xc3,0x83,
0xff,0xf3,0x84,0xc4,0x37,0x29,0x4b,0xb2,0x18,0x01,0x5c,0x40,0x01,0x91,0xc7,0xa2,
0x18,0x58,0xf0,0xf9,0x47,0x18,0x59,0xae,0x7d,0xa1,0x95,0x67,0x21,0x86,0x07,0xe7,
0xab,0x83,0x75,0x2e,0xd3,0x73,0x8d,0x1e,0x71,0x64,0x9d,0x12,0x32,0x6c,0x40,0xb4,
0xc5,0xa1,0xaa,0x26,0xa9,0xd6,0x9d,0x6d,0xe6,0x6a,0xaa,0x88,0x31,0xbf,0xab,0xaa,
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
};
static constexpr size_t FIRE_MP3_LENGTH = sizeof(FIRE_MP3);
