khuongvanan/iot-monitoring-broadcast/firmware/School_Node/tts_ca.h

#pragma once

static const char TTS_CA[] = R"PEM(-----BEGIN CERTIFICATE-----
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
bP6MvPJwNQzcmRk13NfIRmPVNnGuV/u3gm3c
-----END CERTIFICATE-----
-----BEGIN CERTIFICATE-----
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
-----END CERTIFICATE-----
)PEM";
